35services/linear-actuator-crane/cad/renders/outriggers_rack.png

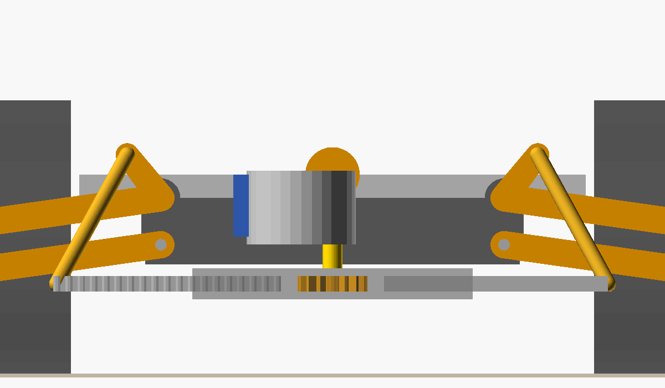
cad/renders/outriggers_rack.png
