35services/linear-actuator-crane/cad/renders/outriggers_worm.png

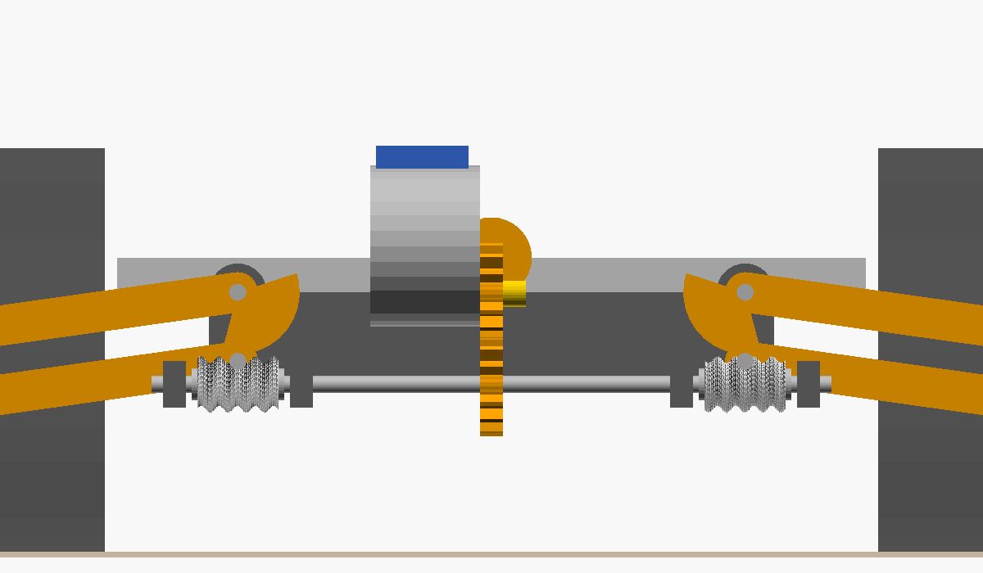
cad/renders/outriggers_worm.png
