35services/linear-actuator-crane/gemini.jpeg

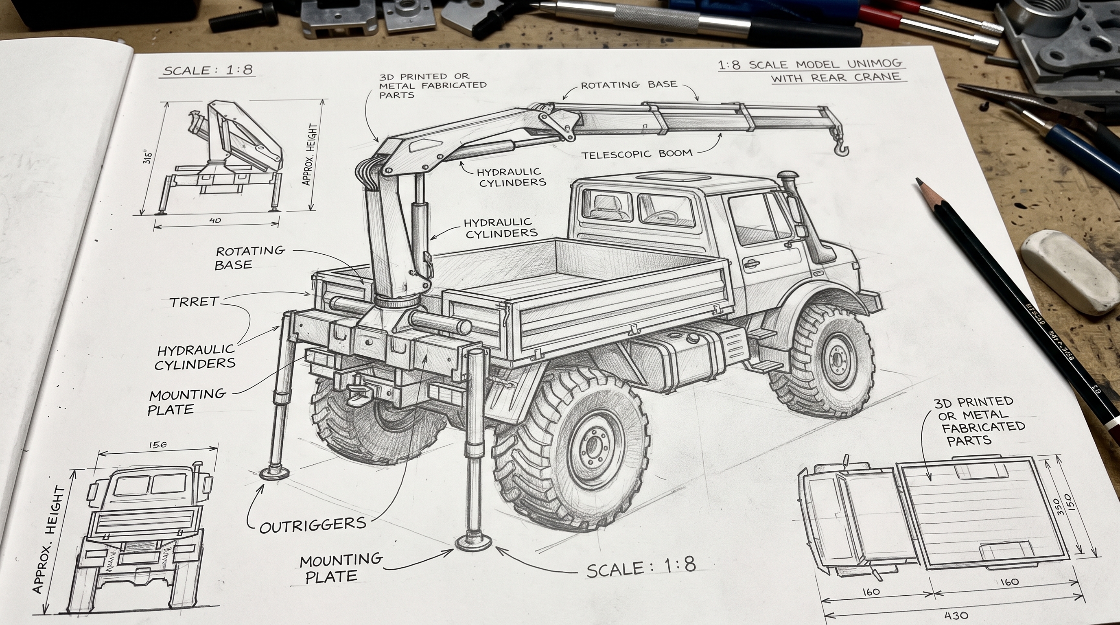
gemini.jpeg
