35services/linear-actuator-crane/pcb/advanced-stack/bottom/renders/board_bottom.png

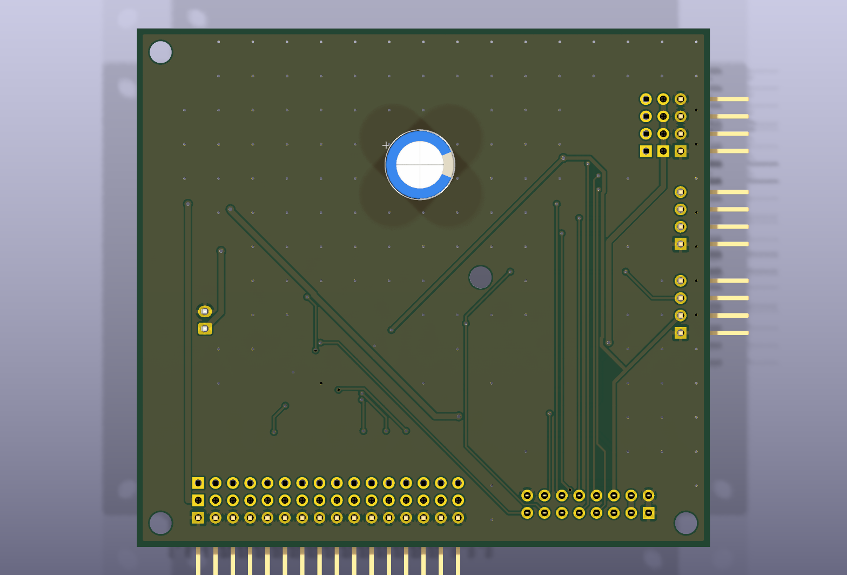
pcb/advanced-stack/bottom/renders/board_bottom.png
