35services/linear-actuator-crane/pcb/advanced-stack/top/renders/board_3d_bottom.png

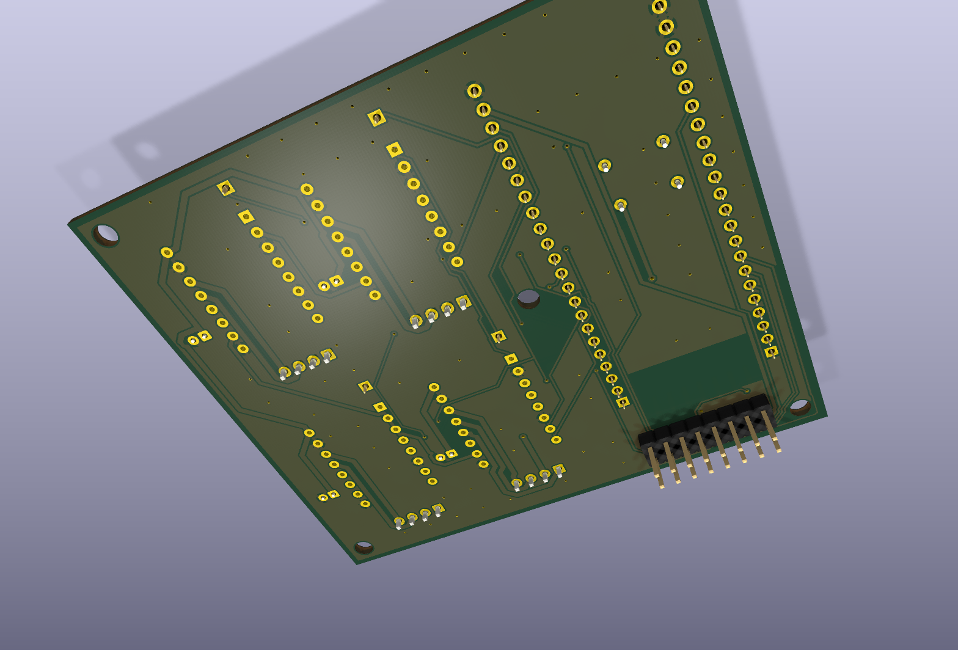
pcb/advanced-stack/top/renders/board_3d_bottom.png
