35services/linear-actuator-crane/pcb/advanced-stack/top/renders/board_bottom.png

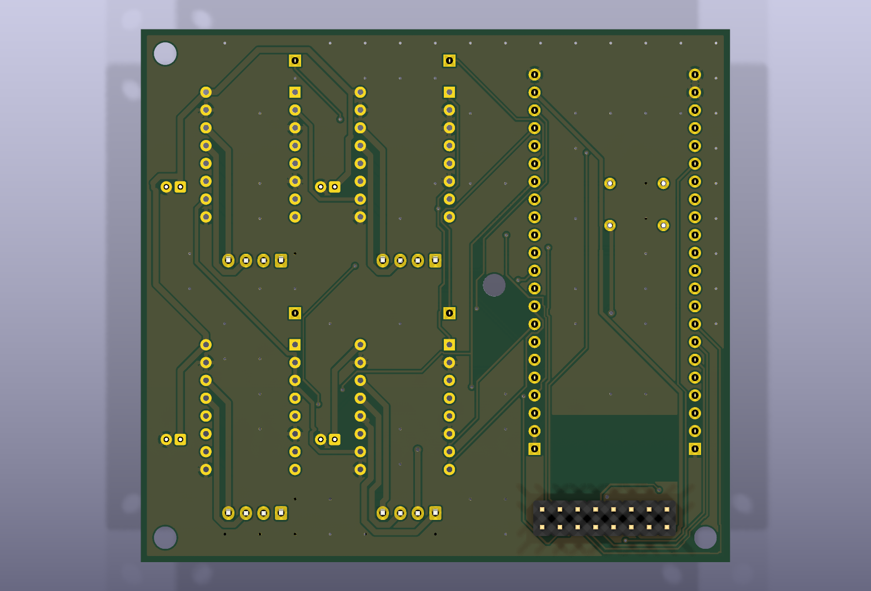
pcb/advanced-stack/top/renders/board_bottom.png
