35services/linear-actuator-crane/pcb/bom.csv

Qty | References | Value | Footprint | LCSC
2 | C1 C2 | 100u 35V | Capacitor_THT:CP_Radial_D8.0mm_P3.50mm
1 | C3 | 470n | Capacitor_THT:C_Disc_D5.0mm_W2.5mm_P5.00mm
1 | C4 | 47u 16V | Capacitor_THT:CP_Radial_D6.3mm_P2.50mm
2 | D2 D3 | 1N4148 | Diode_THT:D_DO-35_SOD27_P7.62mm_Horizontal
1 | D4 | 1N5817 | Diode_THT:D_DO-41_SOD81_P10.16mm_Horizontal
2 | D5 D6 | BAT85 | Diode_THT:D_DO-35_SOD27_P7.62mm_Horizontal
1 | J10 | SuperMini L | Connector_PinSocket_2.54mm:PinSocket_1x08_P2.54mm_Vertical
1 | J11 | SuperMini R | Connector_PinSocket_2.54mm:PinSocket_1x08_P2.54mm_Vertical
1 | J12 | DIAG0 | Connector_PinSocket_2.54mm:PinSocket_1x01_P2.54mm_Vertical
1 | J13 | DIAG1 | Connector_PinSocket_2.54mm:PinSocket_1x01_P2.54mm_Vertical
1 | J2 | Motor lift | Connector_JST:JST_XH_B4B-XH-A_1x04_P2.50mm_Vertical
1 | J3 | Motor tele | Connector_JST:JST_XH_B4B-XH-A_1x04_P2.50mm_Vertical
1 | J4 | RC lift | Connector_PinHeader_2.54mm:PinHeader_1x03_P2.54mm_Vertical
1 | J5 | RC tele | Connector_PinHeader_2.54mm:PinHeader_1x03_P2.54mm_Vertical
2 | JP1 JP2 | UART 4|5 | Jumper:SolderJumper-3_P1.3mm_Open_RoundedPad1.0x1.5mm
3 | R1 R3 R4 | 1k | Resistor_THT:R_Axial_DIN0207_L6.3mm_D2.5mm_P7.62mm_Horizontal
1 | R2 | 10k | Resistor_THT:R_Axial_DIN0207_L6.3mm_D2.5mm_P7.62mm_Horizontal
1 | U2 | TMC2209 #0 lift | Module:Pololu_Breakout-16_15.2x20.3mm
1 | U3 | TMC2209 #1 tele | Module:Pololu_Breakout-16_15.2x20.3mm
1 | U4 | LM2940-5.0 | Package_TO_SOT_THT:TO-220-3_Vertical
