35services/linear-actuator-crane/pcb/advanced/bom.csv

Qty | References | Value | Footprint | LCSC
4 | C1 C2 C3 C4 | 100u 25V | Capacitor_THT:CP_Radial_D5.0mm_P2.00mm
2 | C5 C9 | 10u 25V | Capacitor_SMD:C_0805_2012Metric | C15850
1 | C6 | 22u 25V | Capacitor_SMD:C_0805_2012Metric | C45783
1 | C7 | 1000u 16V | Capacitor_THT:CP_Radial_D10.0mm_P5.00mm
1 | C8 | 100n | Capacitor_SMD:C_0805_2012Metric | C49678
5 | D4 D20 D21 D22 D23 | B5819W | Diode_SMD:D_SOD-123 | C8598
1 | D9 | SS34 | Diode_SMD:D_SMA | C8678
1 | J10 | DevKitC-1 J1 | Connector_PinSocket_2.54mm:PinSocket_1x22_P2.54mm_Vertical
1 | J11 | DevKitC-1 J3 | Connector_PinSocket_2.54mm:PinSocket_1x22_P2.54mm_Vertical
1 | J12 | DIAG0 | Connector_PinSocket_2.54mm:PinSocket_1x01_P2.54mm_Vertical
1 | J13 | DIAG1 | Connector_PinSocket_2.54mm:PinSocket_1x01_P2.54mm_Vertical
1 | J14 | DIAG2 | Connector_PinSocket_2.54mm:PinSocket_1x01_P2.54mm_Vertical
1 | J15 | DIAG3 | Connector_PinSocket_2.54mm:PinSocket_1x01_P2.54mm_Vertical
1 | J20 | Motor 0 | Connector_JST:JST_XH_B4B-XH-A_1x04_P2.50mm_Vertical
1 | J21 | Motor 1 | Connector_JST:JST_XH_B4B-XH-A_1x04_P2.50mm_Vertical
1 | J22 | Motor 2 | Connector_JST:JST_XH_B4B-XH-A_1x04_P2.50mm_Vertical
1 | J23 | Motor 3 | Connector_JST:JST_XH_B4B-XH-A_1x04_P2.50mm_Vertical
1 | J30 | PWM out | rc_crane:PinHeader_3x16_P2.54mm
1 | J4 | RC in | rc_crane:PinHeader_3x04_P2.54mm
1 | J7 | Serial RX | Connector_PinHeader_2.54mm:PinHeader_1x04_P2.54mm_Vertical
1 | J8 | I2C | Connector_PinHeader_2.54mm:PinHeader_1x04_P2.54mm_Vertical
1 | J9 | VM batt | TerminalBlock_Phoenix:TerminalBlock_Phoenix_MKDS-1,5-2-5.08_1x02_P5.08mm_Horizontal
4 | JP1 JP2 JP3 JP4 | UART 4|5 | Jumper:SolderJumper-3_P1.3mm_Open_RoundedPad1.0x1.5mm
1 | JP9 | VM BEC|BATT | Jumper:SolderJumper-3_P1.3mm_Open_RoundedPad1.0x1.5mm
7 | R1 R7 R8 R20 R21 R22 R23 | 1k | Resistor_SMD:R_0805_2012Metric | C17513
2 | R2 R11 | 10k | Resistor_SMD:R_0805_2012Metric | C17414
16 | R40 R41 R42 R43 R44 R45 R46 R47 R48 R49 R50 R51 R52 R53 R54 R55 | 220 | Resistor_SMD:R_0805_2012Metric | C17557
2 | R9 R10 | 4.7k | Resistor_SMD:R_0805_2012Metric | C17673
1 | U10 | TMC2209 #0 | Module:Pololu_Breakout-16_15.2x20.3mm
1 | U11 | TMC2209 #1 | Module:Pololu_Breakout-16_15.2x20.3mm
1 | U12 | TMC2209 #2 | Module:Pololu_Breakout-16_15.2x20.3mm
1 | U13 | TMC2209 #3 | Module:Pololu_Breakout-16_15.2x20.3mm
1 | U4 | AMS1117-5.0 | Package_TO_SOT_SMD:SOT-223-3_TabPin2 | C6187
1 | U5 | PCA9685PW | Package_SO:TSSOP-28_4.4x9.7mm_P0.65mm | C2678753
