35services/linear-actuator-crane/pcb/smd/bom.csv

Qty | References | Value | Footprint | LCSC
2 | C1 C2 | 100u 35V | Capacitor_THT:CP_Radial_D8.0mm_P3.50mm
1 | C3 | 10u 25V | Capacitor_SMD:C_0805_2012Metric | C15850
1 | C4 | 22u 25V | Capacitor_SMD:C_0805_2012Metric | C45783
2 | D2 D3 | 1N4148W | Diode_SMD:D_SOD-123 | C81598
3 | D4 D5 D6 | B5819W | Diode_SMD:D_SOD-123 | C8598
1 | J10 | SuperMini L | Connector_PinSocket_2.54mm:PinSocket_1x08_P2.54mm_Vertical
1 | J11 | SuperMini R | Connector_PinSocket_2.54mm:PinSocket_1x08_P2.54mm_Vertical
1 | J12 | DIAG0 | Connector_PinSocket_2.54mm:PinSocket_1x01_P2.54mm_Vertical
1 | J13 | DIAG1 | Connector_PinSocket_2.54mm:PinSocket_1x01_P2.54mm_Vertical
1 | J2 | Motor lift | Connector_JST:JST_XH_B4B-XH-A_1x04_P2.50mm_Vertical
1 | J3 | Motor tele | Connector_JST:JST_XH_B4B-XH-A_1x04_P2.50mm_Vertical
1 | J4 | RC lift | Connector_PinHeader_2.54mm:PinHeader_1x03_P2.54mm_Vertical
1 | J5 | RC tele | Connector_PinHeader_2.54mm:PinHeader_1x03_P2.54mm_Vertical
2 | JP1 JP2 | UART 4|5 | Jumper:SolderJumper-3_P1.3mm_Open_RoundedPad1.0x1.5mm
3 | R1 R3 R4 | 1k | Resistor_SMD:R_0805_2012Metric | C17513
1 | R2 | 10k | Resistor_SMD:R_0805_2012Metric | C17414
1 | U2 | TMC2209 #0 lift | Module:Pololu_Breakout-16_15.2x20.3mm
1 | U3 | TMC2209 #1 tele | Module:Pololu_Breakout-16_15.2x20.3mm
1 | U4 | AMS1117-5.0 | Package_TO_SOT_SMD:SOT-223-3_TabPin2 | C6187
