35services/linear-actuator-crane/pcb/advanced-stack/bottom/bom.csv

Qty | References | Value | Footprint | LCSC
1 | C6 | 22u 25V | Capacitor_SMD:C_0805_2012Metric | C45783
1 | C7 | 1000u 16V | Capacitor_THT:CP_Radial_D10.0mm_P5.00mm
1 | C8 | 100n | Capacitor_SMD:C_0805_2012Metric | C49678
2 | C9 C5 | 10u 25V | Capacitor_SMD:C_0805_2012Metric | C15850
5 | D4 D20 D21 D22 D23 | B5819W | Diode_SMD:D_SOD-123 | C8598
1 | D9 | SS34 | Diode_SMD:D_SMA | C8678
1 | J1 | 2x8 female 8.5 mm | Connector_PinHeader_2.54mm:PinHeader_2x08_P2.54mm_Vertical
1 | J30 | PWM out, right angle | rc_crane:PinHeader_3x16_P2.54mm_Horizontal
1 | J4 | RC in, right angle | rc_crane:PinHeader_3x04_P2.54mm_Horizontal
1 | J7 | Serial RX, right angle | rc_crane:PinHeader_1x04_P2.54mm_Horizontal
1 | J8 | I2C, right angle | rc_crane:PinHeader_1x04_P2.54mm_Horizontal
1 | J9 | VM batt, side entry | Connector_JST:JST_XH_S2B-XH-A_1x02_P2.50mm_Horizontal
1 | JP9 | VM BEC|BATT | Jumper:SolderJumper-3_P1.3mm_Open_RoundedPad1.0x1.5mm
1 | R11 | 10k | Resistor_SMD:R_0805_2012Metric | C17414
16 | R40 R41 R42 R43 R44 R45 R46 R47 R48 R49 R50 R51 R52 R53 R54 R55 | 220 | Resistor_SMD:R_0805_2012Metric | C17557
6 | R7 R8 R20 R21 R22 R23 | 1k | Resistor_SMD:R_0805_2012Metric | C17513
2 | R9 R10 | 4.7k | Resistor_SMD:R_0805_2012Metric | C17673
1 | U4 | AMS1117-5.0 | Package_TO_SOT_SMD:SOT-223-3_TabPin2 | C6187
1 | U5 | PCA9685PW | Package_SO:TSSOP-28_4.4x9.7mm_P0.65mm | C2678753
