35services/linear-actuator-crane/cad/stl/n20_lid.stl

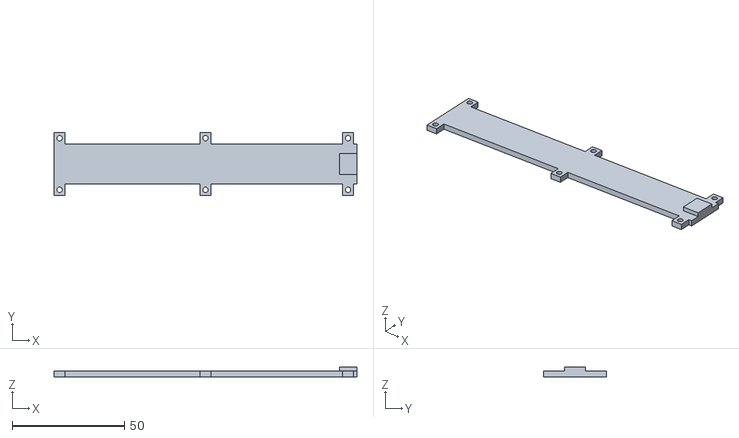
[picture p77: CAD file, 2026-10-24]
cad/stl/n20_lid.stl
135.1 x 28.0 x 4.30
