35services/linear-actuator-crane/cad/stl/n20_tray.stl

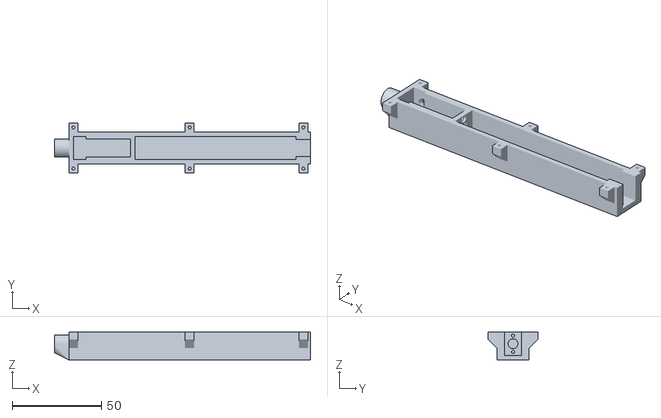
[picture p78: CAD file, 2026-10-24]
cad/stl/n20_tray.stl
143.1 x 28.0 x 15.5
