35services/linear-actuator-crane/cad/stl/n20_ram.stl

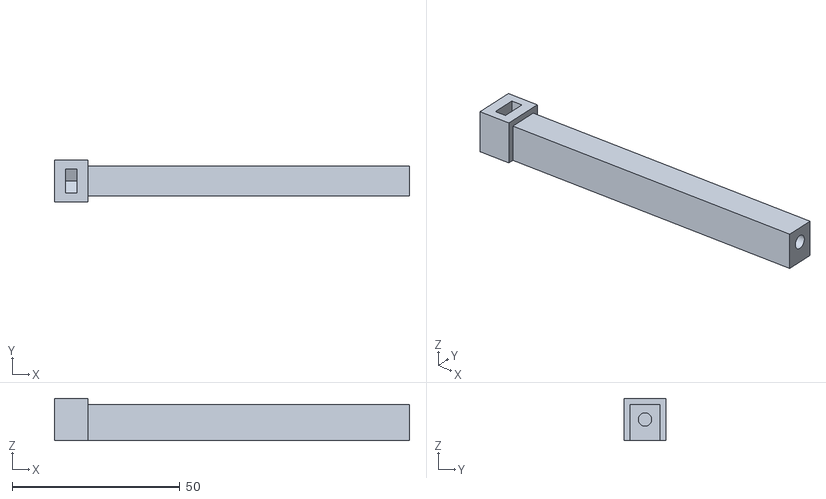
[picture p79: CAD file, 2026-10-24]
cad/stl/n20_ram.stl
105.9 x 12.6 x 12.6
