35services/linear-actuator-crane/cad/stl/actuator_28byj_tray.stl

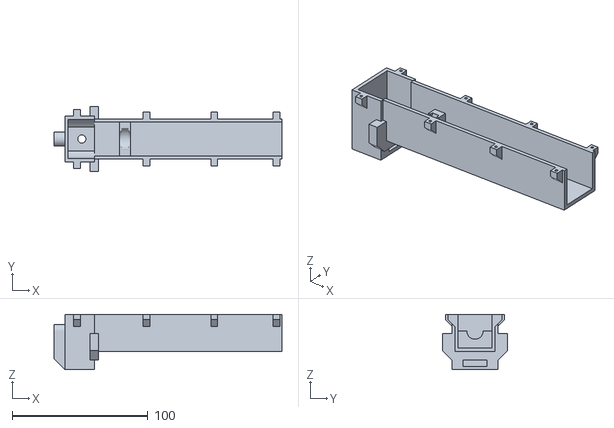
[picture p80: CAD file, 2026-10-24]
cad/stl/actuator_28byj_tray.stl
168.1 x 47.8 x 40.9
