35services/linear-actuator-crane/cad/stl/actuator_28byj_lid.stl

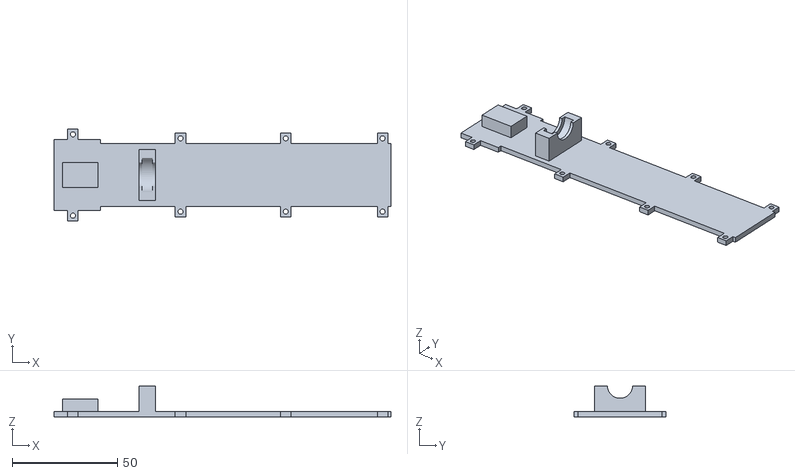
[picture p81: CAD file, 2026-10-24]
cad/stl/actuator_28byj_lid.stl
160.1 x 43.6 x 14.7
