35services/linear-actuator-crane/cad/stl/actuator_28byj_coupler.stl

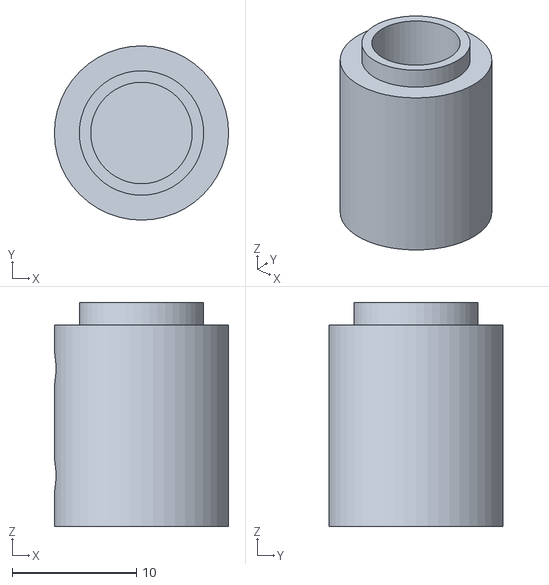
[picture p82: CAD file, 2026-10-24]
cad/stl/actuator_28byj_coupler.stl
14.0 x 14.0 x 18.0
