35services/linear-actuator-crane/cad/stl/actuator_28byj_collar.stl

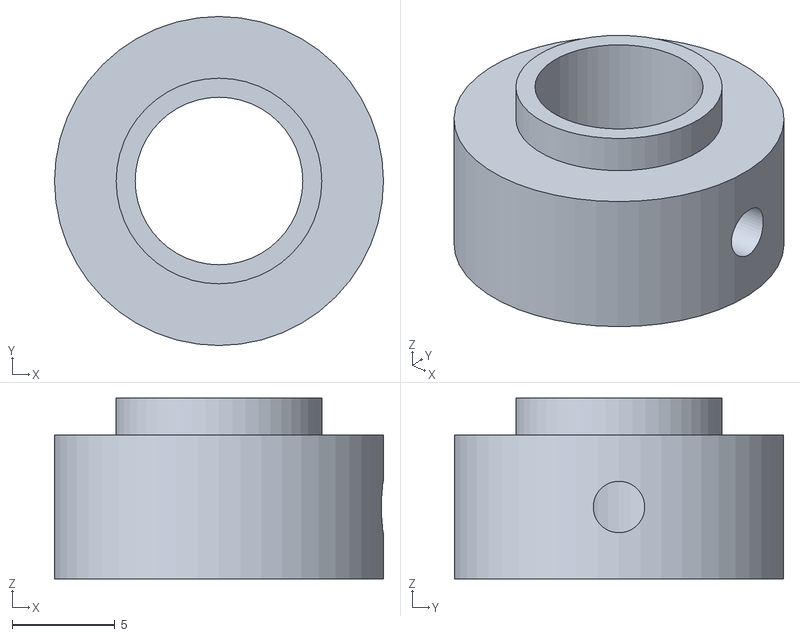
[picture p83: CAD file, 2026-10-24]
cad/stl/actuator_28byj_collar.stl
16.0 x 16.0 x 8.80
