35services/linear-actuator-crane/cad/stl/actuator_28byj_ram.stl

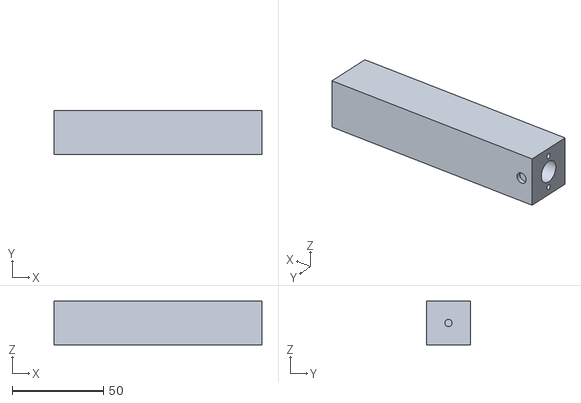
[picture p84: CAD file, 2026-10-24]
cad/stl/actuator_28byj_ram.stl
114.0 x 24.0 x 24.0
