35services/linear-actuator-crane/cad/stl/actuator_tray.stl

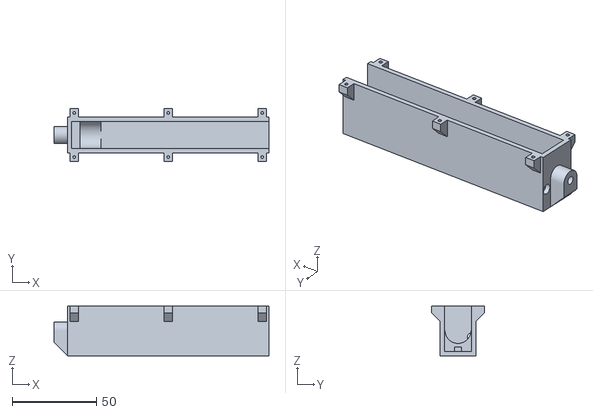
[picture p85: CAD file, 2026-10-22]
cad/stl/actuator_tray.stl
127.5 x 31.3 x 29.4
