35services/linear-actuator-crane/cad/stl/actuator_lid.stl

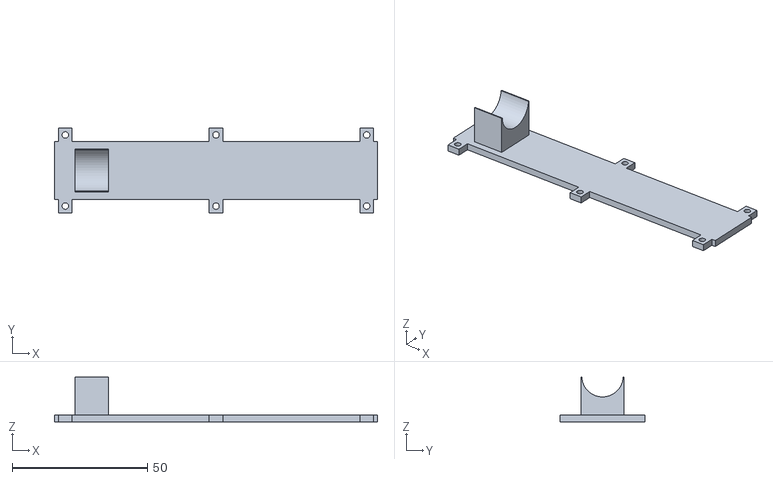
[picture p86: CAD file, 2026-10-22]
cad/stl/actuator_lid.stl
119.5 x 31.3 x 16.6
