35services/linear-actuator-crane/cad/stl/actuator_ram.stl

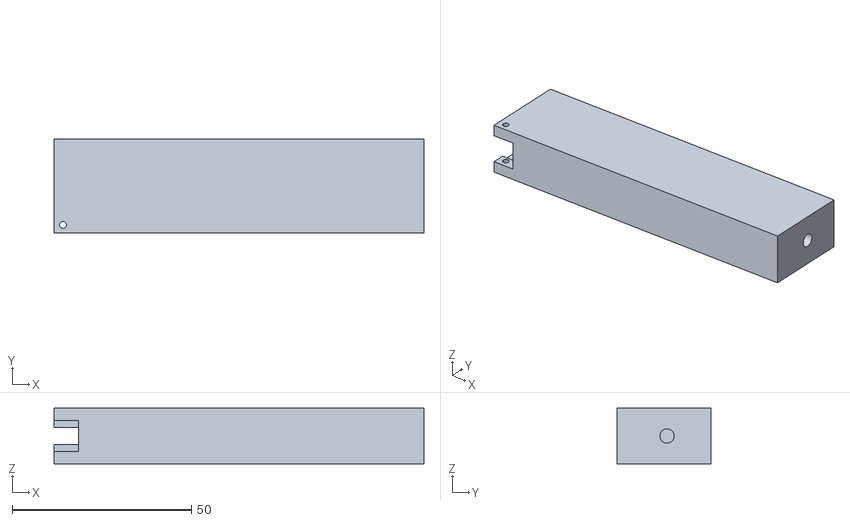
[picture p87: CAD file, 2026-10-22]
cad/stl/actuator_ram.stl
103.2 x 26.3 x 15.5
