35services/linear-actuator-crane/pcb/advanced/rc-crane-advanced.kicad_pcb

## KiCad design pcb/advanced/rc-crane-advanced.kicad_pcb (2026-10-24)

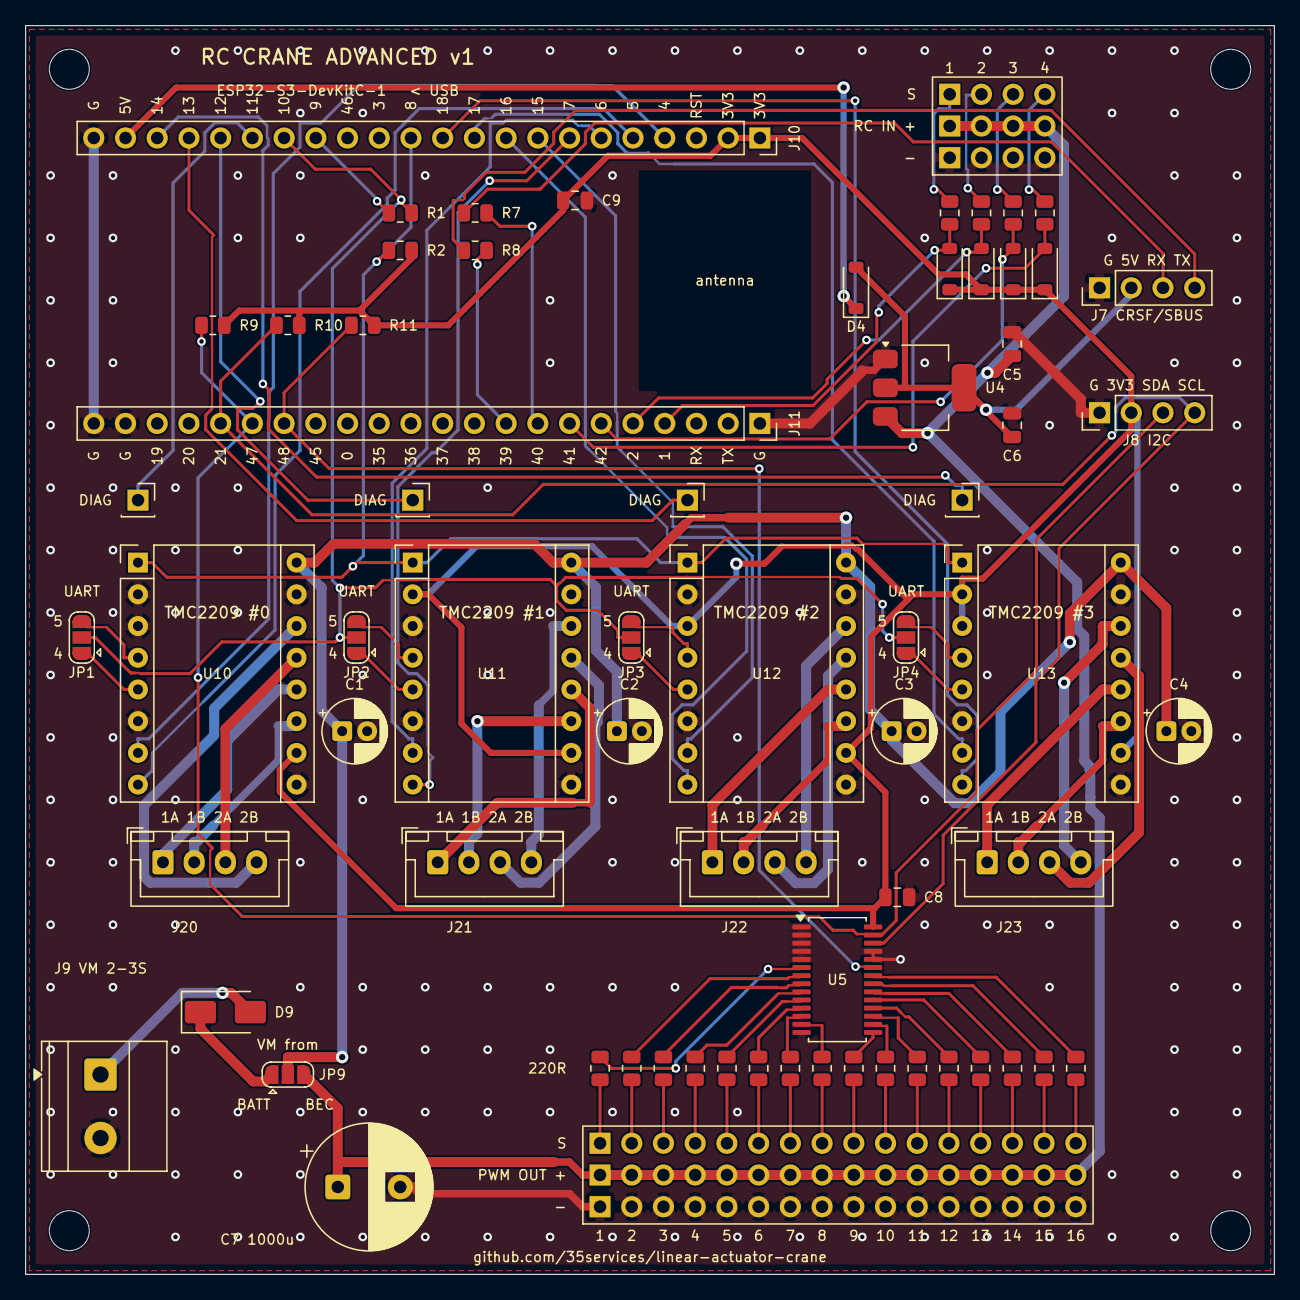
[picture p88: board rc-crane-advanced.kicad_pcb from above]

Board: 2 copper layers, 100.0 x 100.0 mm, 72 parts (0 on the bottom side), 94 nets.

Parts:
C1, C2, C3, C4: 100u 25V; CP_Radial_D5.0mm_P2.00mm
C5, C9: 10u 25V; C_0805_2012Metric
C6: 22u 25V; C_0805_2012Metric
C7: 1000u 16V; CP_Radial_D10.0mm_P5.00mm
C8: 100n; C_0805_2012Metric
D4, D20, D21, D22, D23: B5819W; D_SOD-123
D9: SS34; D_SMA
H1, H2, H3, H4: MountingHole_3.2mm_M3
J4: RC in; PinHeader_3x04_P2.54mm
J7: Serial RX; PinHeader_1x04_P2.54mm_Vertical
J8: I2C; PinHeader_1x04_P2.54mm_Vertical
J9: VM batt; TerminalBlock_Phoenix_MKDS-1,5-2-5.08_1x02_P5.08mm_Horizont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
J10: DevKitC-1 J1; PinSocket_1x22_P2.54mm_Vertical
J11: DevKitC-1 J3; PinSocket_1x22_P2.54mm_Vertical
J12: DIAG0; PinSocket_1x01_P2.54mm_Vertical
J13: DIAG1; PinSocket_1x01_P2.54mm_Vertical
J14: DIAG2; PinSocket_1x01_P2.54mm_Vertical
J15: DIAG3; PinSocket_1x01_P2.54mm_Vertical
J20: Motor 0; JST_XH_B4B-XH-A_1x04_P2.50mm_Vertical
J21: Motor 1; JST_XH_B4B-XH-A_1x04_P2.50mm_Vertical
J22: Motor 2; JST_XH_B4B-XH-A_1x04_P2.50mm_Vertical
J23: Motor 3; JST_XH_B4B-XH-A_1x04_P2.50mm_Vertical
J30: PWM out; PinHeader_3x16_P2.54mm
JP1, JP2, JP3, JP4: UART 4|5; SolderJumper-3_P1.3mm_Open_RoundedPad1.0x1.5mm
JP9: VM BEC|BATT; SolderJumper-3_P1.3mm_Open_RoundedPad1.0x1.5mm
R1, R7, R8, R20, R21, R22, R23: 1k; R_0805_2012Metric
R2, R11: 10k; R_0805_2012Metric
R9, R10: 4.7k; R_0805_2012Metric
R40, R41, R42, R43, R44, R45, R46, R47, R48, R49, R50, R51, R52, R53, R54, R55: 220; R_0805_2012Metric
U4: AMS1117-5.0; SOT-223-3_TabPin2
U5: PCA9685PW; TSSOP-28_4.4x9.7mm_P0.65mm
U10: TMC2209 #0; Pololu_Breakout-16_15.2x20.3mm
U11: TMC2209 #1; Pololu_Breakout-16_15.2x20.3mm
U12: TMC2209 #2; Pololu_Breakout-16_15.2x20.3mm
U13: TMC2209 #3; Pololu_Breakout-16_15.2x20.3mm

Connections:
+3V3: C8.1, C9.1, D20.1, D21.1, D22.1, D23.1, J8.2, J10.1, J10.2, R2.2, R9.2, R10.2, R11.2, U5.28, U10.10, U11.2, U11.10, U12.3, U12.10, U13.2, U13.3, U13.10
+5V: D4.1, J10.21
+5V_REG: C6.1, D4.2, J7.2, U4.2
DIAG0: J10.17, J12.1
DIAG1: J10.18, J13.1
DIAG2: J10.19, J14.1
DIAG3: J10.20, J15.1
DIR0: J10.5, U10.8
DIR1: J10.7, U11.8
DIR2: J10.9, U12.8
DIR3: J10.11, U13.8
EN: J10.12, R2.1, U10.1, U11.1, U12.1, U13.1
GND: C1.2, C2.2, C3.2, C4.2, C5.2, C6.2, C7.2, C8.2, C9.2, J4.9, J4.10, J4.11, J4.12, J7.1, J8.1, J9.2, J10.22, J11.1, J11.21, J11.22, J30.33, J30.34, J30.35, J30.36, J30.37, J30.38, J30.39, J30.40, J30.41, J30.42, J30.43, J30.44, J30.45, J30.46, J30.47, J30.48, U4.1, U5.1, U5.2, U5.3, U5.4, U5.5, U5.14, U5.24, U5.25, U10.2, U10.3, U10.6, U10.9, U10.15, U11.3, U11.6, U11.9, U11.15, U12.2, U12.6, U12.9, U12.15, U13.6, U13.9, U13.15
LED0: R40.2, U5.6
LED1: R41.2, U5.7
LED2: R42.2, U5.8
LED3: R43.2, U5.9
LED4: R44.2, U5.10
LED5: R45.2, U5.11
LED6: R46.2, U5.12
LED7: R47.2, U5.13
LED8: R48.2, U5.15
LED9: R49.2, U5.16
LED10: R50.2, U5.17
LED11: R51.2, U5.18
LED12: R52.2, U5.19
LED13: R53.2, U5.20
LED14: R54.2, U5.21
LED15: R55.2, U5.22
M0_1A: J20.1, U10.12
M0_1B: J20.2, U10.11
M0_2A: J20.3, U10.13
M0_2B: J20.4, U10.14
M1_1A: J21.1, U11.12
M1_1B: J21.2, U11.11
M1_2A: J21.3, U11.13
M1_2B: J21.4, U11.14
M2_1A: J22.1, U12.12
M2_1B: J22.2, U12.11
M2_2A: J22.3, U12.13
M2_2B: J22.4, U12.14
M3_1A: J23.1, U13.12
M3_1B: J23.2, U13.11
M3_2A: J23.3, U13.13
M3_2B: J23.4, U13.14
PWM0: J30.1, R40.1
PWM1: J30.2, R41.1
PWM2: J30.3, R42.1
PWM3: J30.4, R43.1
PWM4: J30.5, R44.1
PWM5: J30.6, R45.1
PWM6: J30.7, R46.1
PWM7: J30.8, R47.1
PWM8: J30.9, R48.1
PWM9: J30.10, R49.1
PWM10: J30.11, R50.1
PWM11: J30.12, R51.1
PWM12: J30.13, R52.1
PWM13: J30.14, R53.1
PWM14: J30.15, R54.1
PWM15: J30.16, R55.1
PWM_OE: J11.16, R11.1, U5.23
RC0: D20.2, J11.4, R20.1
RC0_IN: J4.1, R20.2
RC1: D21.2, J11.5, R21.1
RC1_IN: J4.2, R21.2
RC2: D22.2, J11.6, R22.1
RC2_IN: J4.3, R22.2
RC3: D23.2, J11.7, R23.1
RC3_IN: J4.4, R23.2
SCL: J8.4, J11.18, R10.1, U5.26
SDA: J8.3, J11.17, R9.1, U5.27
SRX: J11.8, R7.2
SRX_IN: J7.3, R7.1
STEP0: J10.4, U10.7
STEP1: J10.6, U11.7
STEP2: J10.8, U12.7
STEP3: J10.10, U13.7
STX: J11.9, R8.2
STX_OUT: J7.4, R8.1
U0_P4: JP1.3, U10.4
U0_P5: JP1.1, U10.5
U1_P4: JP2.3, U11.4
U1_P5: JP2.1, U11.5
U2_P4: JP3.3, U12.4
U2_P5: JP3.1, U12.5
U3_P4: JP4.3, U13.4
U3_P5: JP4.1, U13.5
UART: J10.16, JP1.2, JP2.2, JP3.2, JP4.2, R1.2
UART_TX: J10.15, R1.1
VBAT: D9.1, JP9.1
VBAT_IN: D9.2, J9.1
VBEC: C5.1, C7.1, J4.5, J4.6, J4.7, J4.8, J30.17, J30.18, J30.19, J30.20, J30.21, J30.22, J30.23, J30.24, J30.25, J30.26, J30.27, J30.28, J30.29, J30.30, J30.31, J30.32, JP9.3, U4.3
VM: C1.1, C2.1, C3.1, C4.1, JP9.2, U10.16, U11.16, U12.16, U13.16
