35services/linear-actuator-crane/pcb/advanced-stack/bottom/rc-crane-stack-bottom.kicad_pcb

## KiCad design pcb/advanced-stack/bottom/rc-crane-stack-bottom.kicad_pcb (2026-10-24)

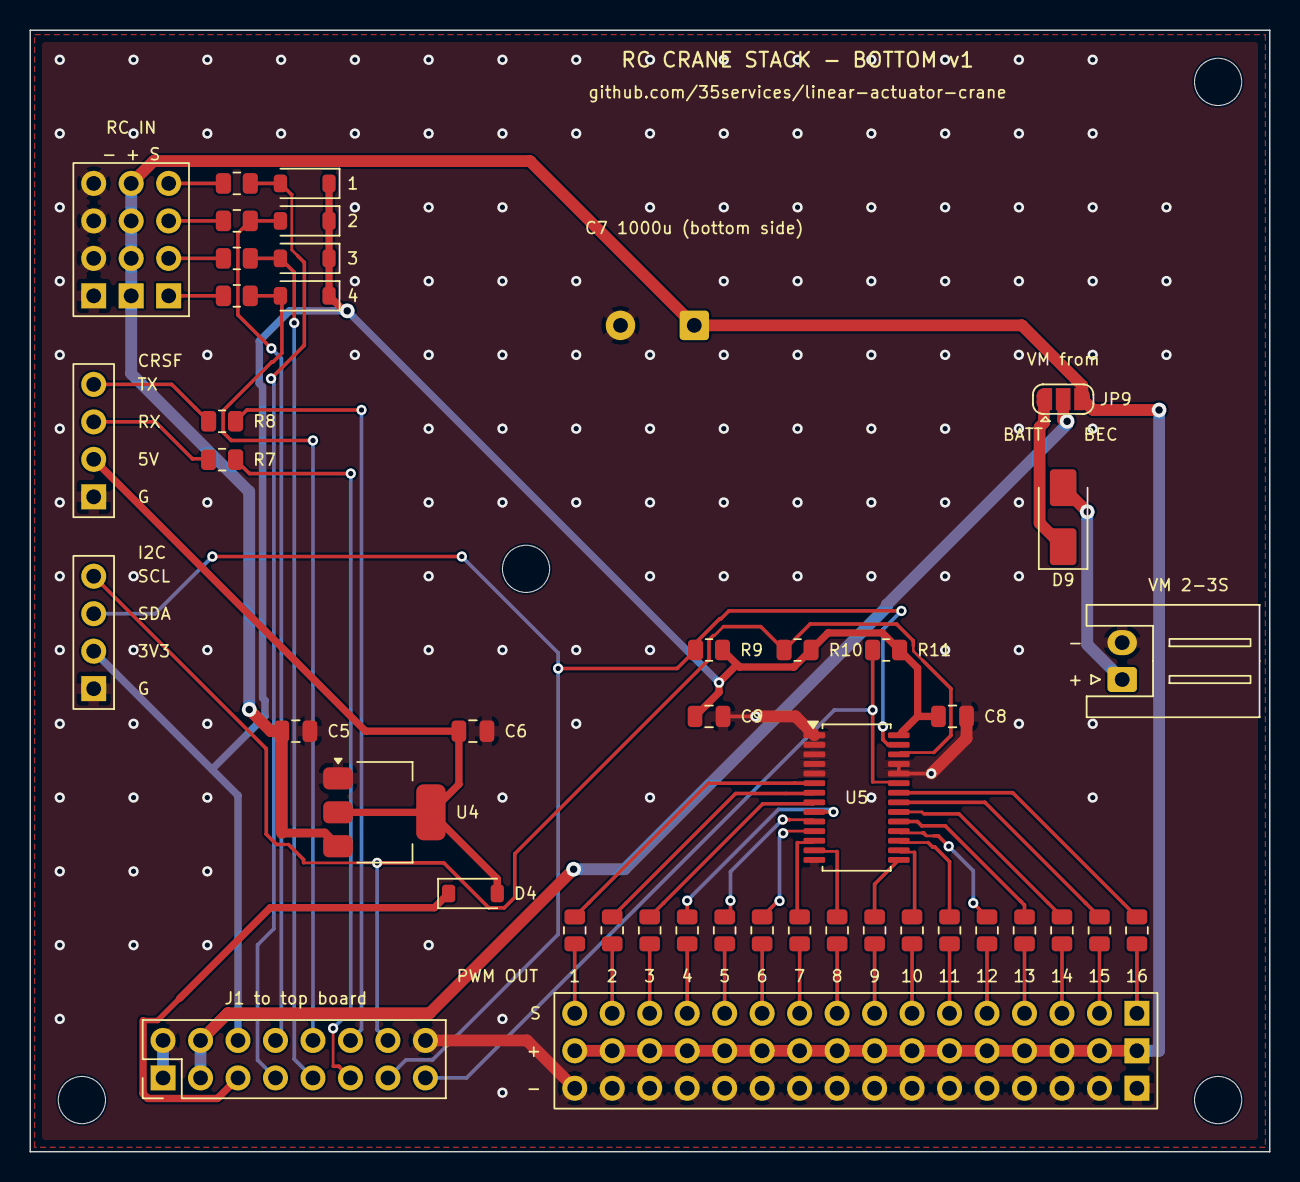
[picture p89: board rc-crane-stack-bottom.kicad_pcb from above]

Board: 2 copper layers, 84.0 x 76.0 mm, 49 parts (1 on the bottom side), 55 nets.

Parts:
C5, C9: 10u 25V; C_0805_2012Metric
C6: 22u 25V; C_0805_2012Metric
C7: 1000u 16V; CP_Radial_D10.0mm_P5.00mm
C8: 100n; C_0805_2012Metric
D4, D20, D21, D22, D23: B5819W; D_SOD-123
D9: SS34; D_SMA
H1, H2, H3, H4: MountingHole_3.2mm_M3
J1: 2x8 female 8.5 mm; PinHeader_2x08_P2.54mm_Vertical
J4: RC in, right angle; PinHeader_3x04_P2.54mm_Horizontal
J7: Serial RX, right angle; PinHeader_1x04_P2.54mm_Horizontal
J8: I2C, right angle; PinHeader_1x04_P2.54mm_Horizontal
J9: VM batt, side entry; JST_XH_S2B-XH-A_1x02_P2.50mm_Horizontal
J30: PWM out, right angle; PinHeader_3x16_P2.54mm_Horizontal
JP9: VM BEC|BATT; SolderJumper-3_P1.3mm_Open_RoundedPad1.0x1.5mm
R7, R8, R20, R21, R22, R23: 1k; R_0805_2012Metric
R9, R10: 4.7k; R_0805_2012Metric
R11: 10k; R_0805_2012Metric
R40, R41, R42, R43, R44, R45, R46, R47, R48, R49, R50, R51, R52, R53, R54, R55: 220; R_0805_2012Metric
U4: AMS1117-5.0; SOT-223-3_TabPin2
U5: PCA9685PW; TSSOP-28_4.4x9.7mm_P0.65mm

Connections:
+3V3: C8.1, C9.1, D20.1, D21.1, D22.1, D23.1, J1.6, J8.2, R9.2, R10.2, R11.2, U5.28
+5V: D4.1, J1.5
+5V_REG: C6.1, D4.2, J7.2, U4.2
GND: C5.2, C6.2, C7.2, C8.2, C9.2, J1.1, J1.2, J1.16, J4.1, J4.2, J4.3, J4.4, J7.1, J8.1, J9.2, J30.1, J30.2, J30.3, J30.4, J30.5, J30.6, J30.7, J30.8, J30.9, J30.10, J30.11, J30.12, J30.13, J30.14, J30.15, J30.16, U4.1, U5.1, U5.2, U5.3, U5.4, U5.5, U5.14, U5.24, U5.25
LED0: R40.2, U5.6
LED1: R41.2, U5.7
LED2: R42.2, U5.8
LED3: R43.2, U5.9
LED4: R44.2, U5.10
LED5: R45.2, U5.11
LED6: R46.2, U5.12
LED7: R47.2, U5.13
LED8: R48.2, U5.15
LED9: R49.2, U5.16
LED10: R50.2, U5.17
LED11: R51.2, U5.18
LED12: R52.2, U5.19
LED13: R53.2, U5.20
LED14: R54.2, U5.21
LED15: R55.2, U5.22
PWM0: J30.48, R40.1
PWM1: J30.47, R41.1
PWM2: J30.46, R42.1
PWM3: J30.45, R43.1
PWM4: J30.44, R44.1
PWM5: J30.43, R45.1
PWM6: J30.42, R46.1
PWM7: J30.41, R47.1
PWM8: J30.40, R48.1
PWM9: J30.39, R49.1
PWM10: J30.38, R50.1
PWM11: J30.37, R51.1
PWM12: J30.36, R52.1
PWM13: J30.35, R53.1
PWM14: J30.34, R54.1
PWM15: J30.33, R55.1
PWM_OE: J1.15, R11.1, U5.23
RC0: D20.2, J1.7, R20.2
RC0_IN: J4.12, R20.1
RC1: D21.2, J1.8, R21.2
RC1_IN: J4.11, R21.1
RC2: D22.2, J1.9, R22.2
RC2_IN: J4.10, R22.1
RC3: D23.2, J1.10, R23.2
RC3_IN: J4.9, R23.1
SCL: J1.14, J8.4, R10.1, U5.26
SDA: J1.13, J8.3, R9.1, U5.27
SRX: J1.11, R7.2
SRX_IN: J7.3, R7.1
STX: J1.12, R8.2
STX_OUT: J7.4, R8.1
VBAT: D9.1, JP9.1
VBAT_IN: D9.2, J9.1
VBEC: C5.1, C7.1, J4.5, J4.6, J4.7, J4.8, J30.17, J30.18, J30.19, J30.20, J30.21, J30.22, J30.23, J30.24, J30.25, J30.26, J30.27, J30.28, J30.29, J30.30, J30.31, J30.32, JP9.3, U4.3
VM: J1.3, J1.4, JP9.2
