35services/linear-actuator-crane/pcb/smd/rc-crane-carrier-smd.kicad_pcb

## KiCad design pcb/smd/rc-crane-carrier-smd.kicad_pcb (2026-10-23)

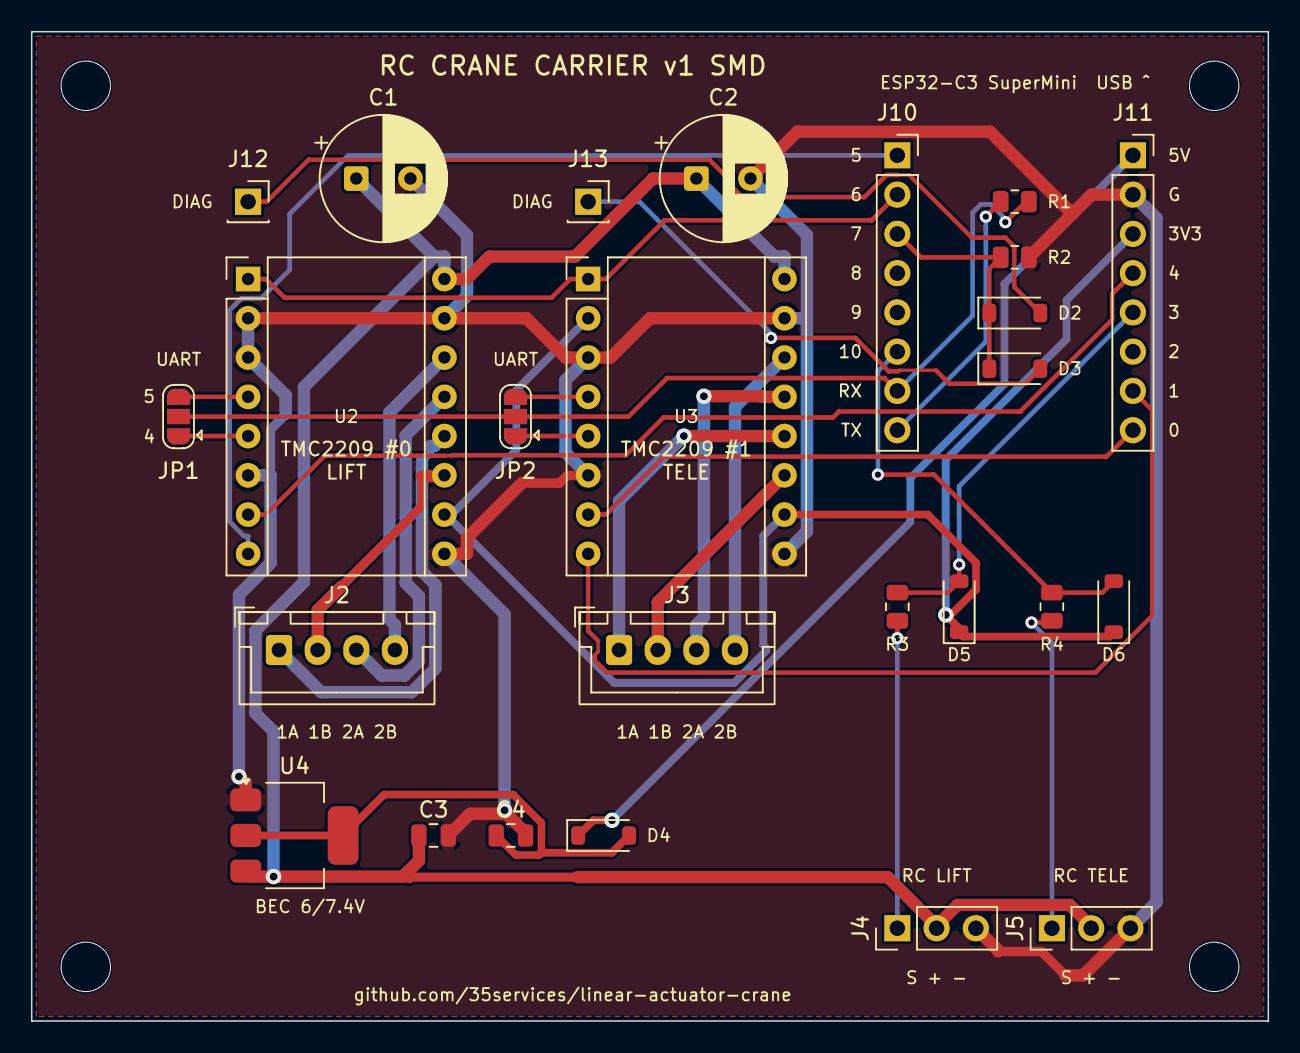
[picture p90: board rc-crane-carrier-smd.kicad_pcb from above]

Board: 2 copper layers, 80.0 x 64.0 mm, 30 parts (0 on the bottom side), 31 nets.

Parts:
C1, C2: 100u 35V; CP_Radial_D8.0mm_P3.50mm
C3: 10u 25V; C_0805_2012Metric
C4: 22u 25V; C_0805_2012Metric
D2, D3: 1N4148W; D_SOD-123
D4, D5, D6: B5819W; D_SOD-123
H1, H2, H3, H4: MountingHole_3.2mm_M3
J2: Motor lift; JST_XH_B4B-XH-A_1x04_P2.50mm_Vertical
J3: Motor tele; JST_XH_B4B-XH-A_1x04_P2.50mm_Vertical
J4: RC lift; PinHeader_1x03_P2.54mm_Vertical
J5: RC tele; PinHeader_1x03_P2.54mm_Vertical
J10: SuperMini L; PinSocket_1x08_P2.54mm_Vertical
J11: SuperMini R; PinSocket_1x08_P2.54mm_Vertical
J12: DIAG0; PinSocket_1x01_P2.54mm_Vertical
J13: DIAG1; PinSocket_1x01_P2.54mm_Vertical
JP1, JP2: UART 4|5; SolderJumper-3_P1.3mm_Open_RoundedPad1.0x1.5mm
R1, R3, R4: 1k; R_0805_2012Metric
R2: 10k; R_0805_2012Metric
U2: TMC2209 #0 lift; Pololu_Breakout-16_15.2x20.3mm
U3: TMC2209 #1 tele; Pololu_Breakout-16_15.2x20.3mm
U4: AMS1117-5.0; SOT-223-3_TabPin2

Connections:
+3V3: D5.1, D6.1, J11.3, U2.10, U3.2, U3.10
+5V: D4.1, J11.1
+5V_REG: C4.1, D4.2, U4.2
DIAG: D2.1, D3.1, J10.3, R2.1
DIAG0: D2.2, J12.1
DIAG1: D3.2, J13.1
DIR0: J10.1, U2.8
DIR1: J11.7, U3.8
EN: J10.2, U2.1, U3.1
GND: C1.2, C2.2, C3.2, C4.2, J4.3, J5.3, J11.2, R2.2, U2.2, U2.3, U2.6, U2.9, U2.15, U3.3, U3.6, U3.9, U3.15, U4.1
M0_1A: J2.1, U2.12
M0_1B: J2.2, U2.11
M0_2A: J2.3, U2.13
M0_2B: J2.4, U2.14
M1_1A: J3.1, U3.12
M1_1B: J3.2, U3.11
M1_2A: J3.3, U3.13
M1_2B: J3.4, U3.14
RC0: D5.2, J11.5, R3.2
RC0_IN: J4.1, R3.1
RC1: D6.2, J10.6, R4.2
RC1_IN: J5.1, R4.1
STEP0: J11.4, U2.7
STEP1: J11.8, U3.7
U0_P4: JP1.3, U2.4
U0_P5: JP1.1, U2.5
U1_P4: JP2.3, U3.4
U1_P5: JP2.1, U3.5
UART: J10.7, JP1.2, JP2.2, R1.2
UART_TX: J10.8, R1.1
VBEC: C1.1, C2.1, C3.1, J4.2, J5.2, U2.16, U3.16, U4.3
