35services/linear-actuator-crane/(commit log)

2026-10-22 RC crane with stepper linear actuators
    - README: wiring diagram, parts list, power, mechanics and firmware
    setup for driving two mini stepper linear actuators (boom lift +
    telescope) from an RC receiver via ESP32-C3 and 2x TMC2209
    - firmware/rc_crane: Arduino sketch with sensorless (StallGuard) or
    hard-stop homing, position/rate RC control, failsafe and idle
    driver disable
    - cad/crane.scad: parametric OpenSCAD concept of the crane with
    telescopic boom, echoes required stroke and tip-force ratio
    - cad/actuator_housing.scad + STLs: 3D printed enclosure turning the
    15 mm slider actuator into an enclosed ram-type actuator
    [actuator_housing.scad, actuator_lid.stl, actuator_ram.stl, actuator_tray.stl, crane.scad]
2026-10-22 Add CAD gallery, render script and GitHub Action
    - cad/render.sh regenerates the STLs and PNG previews from the
    OpenSCAD sources; STL facets are sorted so unchanged geometry
    gives byte-identical files
    - cad/README.md shows all renderings and links the printable parts
    - renders moved to cad/renders/, more views added (side views,
    individual parts)
    - .github/workflows/render-cad.yml renders on every CAD change and
    commits the results on main, uploads them as artifact on PRs
    [actuator_lid.stl, actuator_ram.stl, actuator_tray.stl]
2026-10-22 Update CAD renders
2026-10-22 Power the ESP32 from the 6 V / 7.4 V BEC via LM2940
    The Hobbywing QuicRun Fusion SE BEC is switchable 6 V / 7.4 V (4 A),
    too much for the SuperMini's 5V pin. Replace the optional buck
    converter with an LM2940-5.0 LDO plus a 1N5817 against USB back-feed,
    replace the optional RC signal divider with a 1 kΩ + BAT85 clamp that
    works for any receiver signal level, and add a 1N5822 reverse
    polarity diode in the battery line.
2026-10-22 Add carrier PCB for ESP32-C3 SuperMini + 2x TMC2209
    Two-layer through-hole board generated from a parts/nets table
    (pcb/generate_pcb.py), autorouted with Freerouting and checked with
    KiCad DRC (0 violations, 0 unconnected). Includes Gerbers + drill
    ready to order, BOM, 3D renders and a one-command build script.
    Also document why the TMC2209 module potentiometer has no effect
    when current is set over UART.
    [bom.csv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]
2026-10-22 Add SMD variant of the carrier PCB for JLCPCB assembly
    generate_pcb.py and build.sh now build two variants side by side:
    tht (unchanged, hand soldered) and smd (pcb/smd/). The SMD variant
    replaces passives, diodes and the regulator with LCSC parts (verified
    against lcsc.com) and writes jlcpcb_bom.csv + jlcpcb_cpl.csv; sockets,
    headers, JST connectors and the battery terminal stay through-hole
    for hand soldering. AMS1117-5.0 replaces the LM2940 (no verified SMD
    LM2940 at JLCPCB). DRC: 0 violations, 0 unconnected.
    Claude-Session: https://claude.ai/code/session_01JATcLE25KWRaki615r1Lis
    [bom.csv, jlcpcb_bom.csv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]
2026-10-22 PCB docs: renders, layout drawings and READMEs for both variants
    - build.sh also renders a 3D view from below and SVG layout drawings
    (front/back copper + silkscreen) per variant
    - pcb/README.md covers the THT and SMD variants with all images,
    parts lists and the pre-order checks
    - pcb/smd/README.md: step-by-step JLCPCB ordering and bring-up
    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
    [rc-crane-carrier-B_Cu.gbl, rc-crane-carrier-B_Mask.gbs, rc-crane-carrier-B_Paste.gbp, rc-crane-carrier-B_Silkscreen.gbo, rc-crane-carrier-Edge_Cuts.gm1, rc-crane-carrier-F_Cu.gtl, rc-crane-carrier-F_Mask.gts, rc-crane-carrier-F_Paste.gtp]
2026-10-22 PCB: power the drivers from the BEC, drop the battery input
    The drivers' VM now comes from the ESC's BEC (6 V / 7.4 V, 4 A) through
    the RC headers, like the ESP32's regulator. Removes the battery
    terminal J1 and the reverse polarity diode D1 (the + pin in the middle
    of the S + - header makes a reversed servo plug harmless), and the
    board shrinks to 80 x 64 mm. Both variants: DRC 0 violations,
    0 unconnected.
    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
    [bom.csv, jlcpcb_bom.csv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]
2026-10-22 Docs: power everything from the BEC, no separate battery input
    Update the main README (parts, wiring diagram, power section, current
    budget) and both PCB READMEs for the BEC-only power path and the
    80 x 64 mm board.
    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
2026-10-22 Document the DIAG stall signal with a 3D illustration
    cad/diag_wire_example.scad shows a mock TMC2209 StepStick on the
    carrier PCB with a Dupont jumper from its DIAG pin to J12. Rendered by
    cad/render.sh (and CI), shown in the main README wiring section, the
    CAD gallery and the PCB README.
    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
    [diag_wire_example.scad]
2026-10-23 SMD board: 100 uF capacitors as THT, track JLCPCB extended parts
    The SMD 100 uF electrolytic (C2836442) was the only extended part on the
    SMD carrier. C1/C2 now use the THT footprint and are hand-soldered, so the
    JLCPCB assembly has basic parts only. check_jlc_parts.py lists basic/extended
    status and stock for every LCSC part in the BOMs.
    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
    [bom.csv, jlcpcb_bom.csv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]
2026-10-23 Measure the lead screw, real actuator in the crane model, speed section
    Thread counted on the listing photo: 0.5 mm lead, ~172 turns on 86.6 mm,
    ~76 mm travel. crane.scad now uses the enclosed actuator (132.5 mm, 75 mm
    stroke) via use <actuator_housing.scad>, with a hanger under the boom for
    the lift actuator and a bracket on the inner section for the telescope.
    It echoes actuator speed, boom and telescope travel times and hook speed.
    README gets a Speed section with the photo; firmware strokes 49.5 / 75 mm.
    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
    [actuator_housing.scad, crane.scad]
2026-10-23 Firmware: web settings page with properties stored in flash
    The ESP32 opens a WiFi access point (rc-crane-xxxx) and serves a settings
    page at 192.168.4.1. Settings are registered in a table (settings.h): key,
    group, label, unit, range, step; the page builds its form from
    /api/settings, values are stored in NVS and applied immediately.
    Registered: max speed, acceleration, homing speed, RC deadband, WiFi
    timeout, and per axis stroke, control mode, currents, stall threshold,
    invert. Live status shows positions and RC sticks. The web server pauses
    while an axis moves so stepping stays smooth.
    Claude-Session: https://claude.ai/code/session_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
    [rc_crane.ino, settings.h, web_ui.h]
2026-10-23 Advanced board: ESP32-S3-DevKitC-1, 4x TMC2209, PCA9685 with 16 PWM outputs
    100 x 100 mm, two layers, SMD parts for JLCPCB assembly (39 placements,
    only the PCA9685 is an extended part). 4 StepStick sockets on one UART
    (addresses 0-3 by copper), DIAG per driver, 4 RC PWM inputs with clamps,
    CRSF/SBUS port with 5 V, I2C header, 16 servo/ESC outputs in an S+- block,
    VM from the BEC or a 2-3S battery (solder jumper), antenna keepout.
    pcb/advanced/generate_advanced.py builds it with the existing helpers and
    cleans up after Freerouting (redundant vias, dead-end tracks, neck-downs,
    GND stitching). DRC: 0 violations, 0 unconnected.
    Claude-Se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
    [bom.csv, jlcpcb_bom.csv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]
2026-10-23 PCB: move the generic board building into pcb/board_tools.py
    The advanced board's generator now only holds its tables; placement,
    header blocks, autorouter clean-up, GND stitching and pours live in
    board_tools.py so the stacked boards can reuse them. Same result:
    DRC 0 violations, 0 unconnected, BOM unchanged.
    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
    [rc-crane-advanced-B_Cu.gbl, rc-crane-advanced-B_Mask.gbs, rc-crane-advanced-B_Paste.gbp, rc-crane-advanced-B_Silkscreen.gbo, rc-crane-advanced-Edge_Cuts.gm1, rc-crane-advanced-F_Cu.gtl, rc-crane-advanced-F_Mask.gts, rc-crane-advanced-F_Paste.gtp]
2026-10-24 Stacked version of the advanced board: two 84 x 76 mm boards
    pcb/advanced-stack: top board (DevKitC-1, 4x TMC2209, motors; through-hole
    only) and bottom board (PCA9685 + 16 outputs, RC/CRSF/I2C inputs, 5 V
    regulator, VM input; JLCPCB SMD), joined by a 2x8 stacking header on
    shared M3 holes. Bottom-board connectors are right-angle headers pointing
    out of the edges so they stay reachable under the top board; the servo
    buffer cap sits on the underside. Same nets as the single board.
    board_tools: edge keepout border for the autorouter, island removal,
    neck-downs only widened where the clearance allows (min. 0.125 mm),
    right-angle header blocks, per-part 3D model overrides and bottom-side
    parts.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
    [bom.csv, jlcpcb_bom.csv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]
2026-10-24 Compare linear actuators: stepper slider, DC micro cylinder, 12 V with limit switches
    docs/actuator_comparison.md with listing photos (docs/actuators/), the
    data readable from the listings, end detection by current sensing (DRV8876
    IPROPI, thresholds, blanking, timeout, ripple counting), JLCPCB driver
    options and a test plan for the samples.
    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
2026-10-24 Actuator comparison: what our boards need to drive DC actuators
    Requirements per actuator type (driver, supply, ESP pins, firmware),
    DRV8876 current sense wiring (IPROPI, VREF current limit), what each
    board would need (C3 ADC pins, S3 ADC1 vs WiFi), mini brushed ESCs on
    PCA9685 outputs for limit-switch actuators, and a shopping list.
    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
2026-10-24 N20 DC lead screw actuator: printed housing for the 12GA-N20 with M4 x 100 mm screw
    Tray, lid and ram like the stepper housing. An M4 hex nut rides in the
    ram's square piston, the gearbox screws to a bulkhead, and printed hard
    stops at both ends give 80 mm stroke for current-sense homing.
    Listing photo and drawing in docs/actuators, option 4 in the comparison.
    [n20_actuator.scad, n20_lid.stl, n20_ram.stl, n20_tray.stl]
2026-10-24 28BYJ-48 lead screw actuator, ULN2003 option in the comparison
    cad/actuator_28byj.scad: printed T8 lead screw actuator around the 28BYJ-48
    geared stepper - motor clamped with its ears in slots, printed coupler and
    collar clamp the screw to a 688 bearing that takes all axial load, T8
    flange nut on a square ram, optional magnet + hall sensor home position,
    M3 inserts at both ends. Collision-checked at 0/37.5/75 mm with positive
    controls. Shared housing pieces moved to actuator_common.scad; the slider
    housing uses them with byte-identical STLs.
    Comparison: options 4 (28BYJ + TMC2209, bipolar mod) and 5 (28BYJ + its
    ULN2003 board) with photos, end detection without current information,
    4 ULN200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
    [actuator_28byj.scad, actuator_28byj_collar.stl, actuator_28byj_coupler.stl, actuator_28byj_lid.stl, actuator_28byj_ram.stl, actuator_28byj_tray.stl, actuator_common.scad, actuator_housing.scad]
2026-10-24 README: overview gallery with the current renders
    Crane side views, all three actuators (slider housing, 28BYJ-48, N20), all
    boards (carrier THT/SMD, advanced, stack top/bottom) and the web settings
    page. All images are the files CI keeps rendering, so they stay current.
    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
2026-10-24 WiFi switches off 20 s after homing without a client
    The setting is now in seconds (new key wifi_off_s, 0-3600 s), so an old
    stored "10 min" isn't read as 10 s. Ideas for later: with RMT stepping the
    default can go back up.
2026-10-24 Remote control comparison: RC/ELRS, Bluepad32, WiFi app
    Compares four ways to control the whole vehicle from the advanced board:
    an ELRS receiver on the CRSF port, a PlayStation controller via Bluepad32,
    a WiFi Android app, and an app with a gamepad on the phone. Covers
    failsafe, range, latency, effort and cost per option, notes that
    DS4/DualSense need Bluetooth Classic (original ESP32, not the S3), and
    that the PCA9685 keeps outputting when the ESP hangs. Linked from the
    main README and the advanced board README.
2026-10-24 Optionally skip homing after a clean stop
    New web setting Homing -> "Skip homing after a clean stop" (default off, so
    homing on every boot stays the default). When on, the positions are stored in
    NVS once the crane stands still with the drivers off, and marked invalid before
    the first step of the next move, so a power cut mid-move still homes on boot.
    Stored positions are only used if steps/mm, the invert setting and the stroke
    range still match. "Restart + home" and TUNE_STALLGUARD always home next boot.
    README: new section, list item in "Ideas for later" marked done.
    [rc_crane.ino, web_ui.h]
2026-10-24 Use cases: bowden outriggers and a crane driven through bowden tubes
    The actuator pushes and pulls a 1.75 mm PETG filament in a PTFE tube, like a
    3D printer's bowden extruder, so it can lie flat on the vehicle.
    - cad/use-cases/bowden_outriggers.scad: one actuator under the chassis swings
    two hinged feet down; they lock 10° over centre and fold flat under the
    chassis. Added to crane.scad as option `outriggers`.
    - cad/use-cases/crane_bowden.scad: copy of crane.scad with both actuators flat
    on the deck; luffing line from an A-frame, telescope pulled back against a
    constant-force spring. Tension only, tube bends >= 20 mm checked.
    - bowden_common.scad: tube paths, fittings, bend radius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
    [actuator_housing.scad, bowden_common.scad, bowden_outriggers.scad, crane.scad, crane_bowden.scad, n20_actuator.scad]
2026-10-24 Animated GIFs of the CAD models in the READMEs
    render.sh gets a gif() helper: OpenSCAD --animate renders one loop of the
    model's own $t animation, ffmpeg turns the frames into a palette-optimised
    GIF. Crane, bowden crane, bowden outriggers and the three actuators (section
    view, ram moving) are rendered this way. The Render CAD workflow installs
    ffmpeg and commits the GIFs with the PNGs.
2026-10-24 Retry GIF animations that crash under xvfb, 24 bit xvfb screen
    On CI OpenSCAD died 4 frames into an --animate run with an X BadRequest.
    Retry each animation up to three times and run xvfb with a 24 bit screen
    instead of xvfb-run's 640x480x8 default.
2026-10-24 Render GIF frames one OpenSCAD run at a time
    --animate kept dying with X errors under xvfb on CI, retries and a 24 bit
    screen didn't help. Each frame now gets its own run, like the PNG previews,
    through a small wrapper that sets $t and includes the model (2021.01
    ignores -D '$t=...').
2026-10-24 Outriggers: rear stabilizer legs that swing out and lock, actuator on the deck
    Redesign of use case 1 after the LEGO 42082 extended stabilizer legs
    (MOC-50496): two parallelogram legs behind the rear axle swing from folded
    up (85°) out beyond the wheels (pads at ±103 mm, wheels end at 97); the pad
    stays level and its last 10° are 10.4 mm down, 0.5 mm sideways. A filament
    pulls a horn on the upper link (deploy = pull, 20.3 mm travel), a spring
    pawl drops into a notch in the hub to lock the leg, a lost-motion slot
    lifts it when pushing back. The actuator lies on the deck (in
    crane_bowden.scad on top of the luffing actuator); tubes arch down into
    the leg tube ends, tightest bends 20.3 / 22.1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
    [bowden_outriggers.scad, crane.scad, crane_bowden.scad]
2026-10-24 README: outriggers are now rear stabilizer legs
    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
2026-10-24 Geared outrigger options (worm, rack and pinion), GIFs, CLAUDE.md
    cad/use-cases/outriggers_geared.scad drives the same parallelogram legs
    with one 28BYJ-48 at the rear: drive="worm" (wheel sectors on the upper
    link hubs, L/R worms on one cross shaft; 1:24, 25 s, self-locking at any
    angle, torque-limited with a 28BYJ) or drive="rack" (pinion between two
    racks driven apart, pushrods to horns behind the upper links; 23.5 mm,
    1.9 s, locks at dead centre 0.14° off). Rack pushrods collision-checked at
    10 poses with a positive control. Comparison table bowden / worm / rack
    in the use-case README, recommendation: rack.
    bowden_outriggers.scad: leg_parts(bowden = false), rear_beam(),
    vehicle_scene()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
    [bowden_outriggers.scad, outriggers_geared.scad]
